UAlberta-EcoCar/Sally-Electrical-Design/README.md

View this project on [CADLAB.io](https://cadlab.io/project/29553). 

# EcoCar Sally Prototype
***This is the official repository for the 2024-2025 EcoCar prototype, Sally***

Much of the systems of this vehicle will build on the innovations implemented in Lucy. Utilizing CANbus, we can easily add more modules to our overall system. We will also be employing power distribution networks alongside CANbus as to create a more intensively modular system.
