UAlberta-EcoCar/Sally-Electrical-Design/Hardware/Rev1/defogger_and_wiper.kicad_pcb

## KiCad design Hardware/Rev1/defogger_and_wiper.kicad_pcb (2026-05-02)

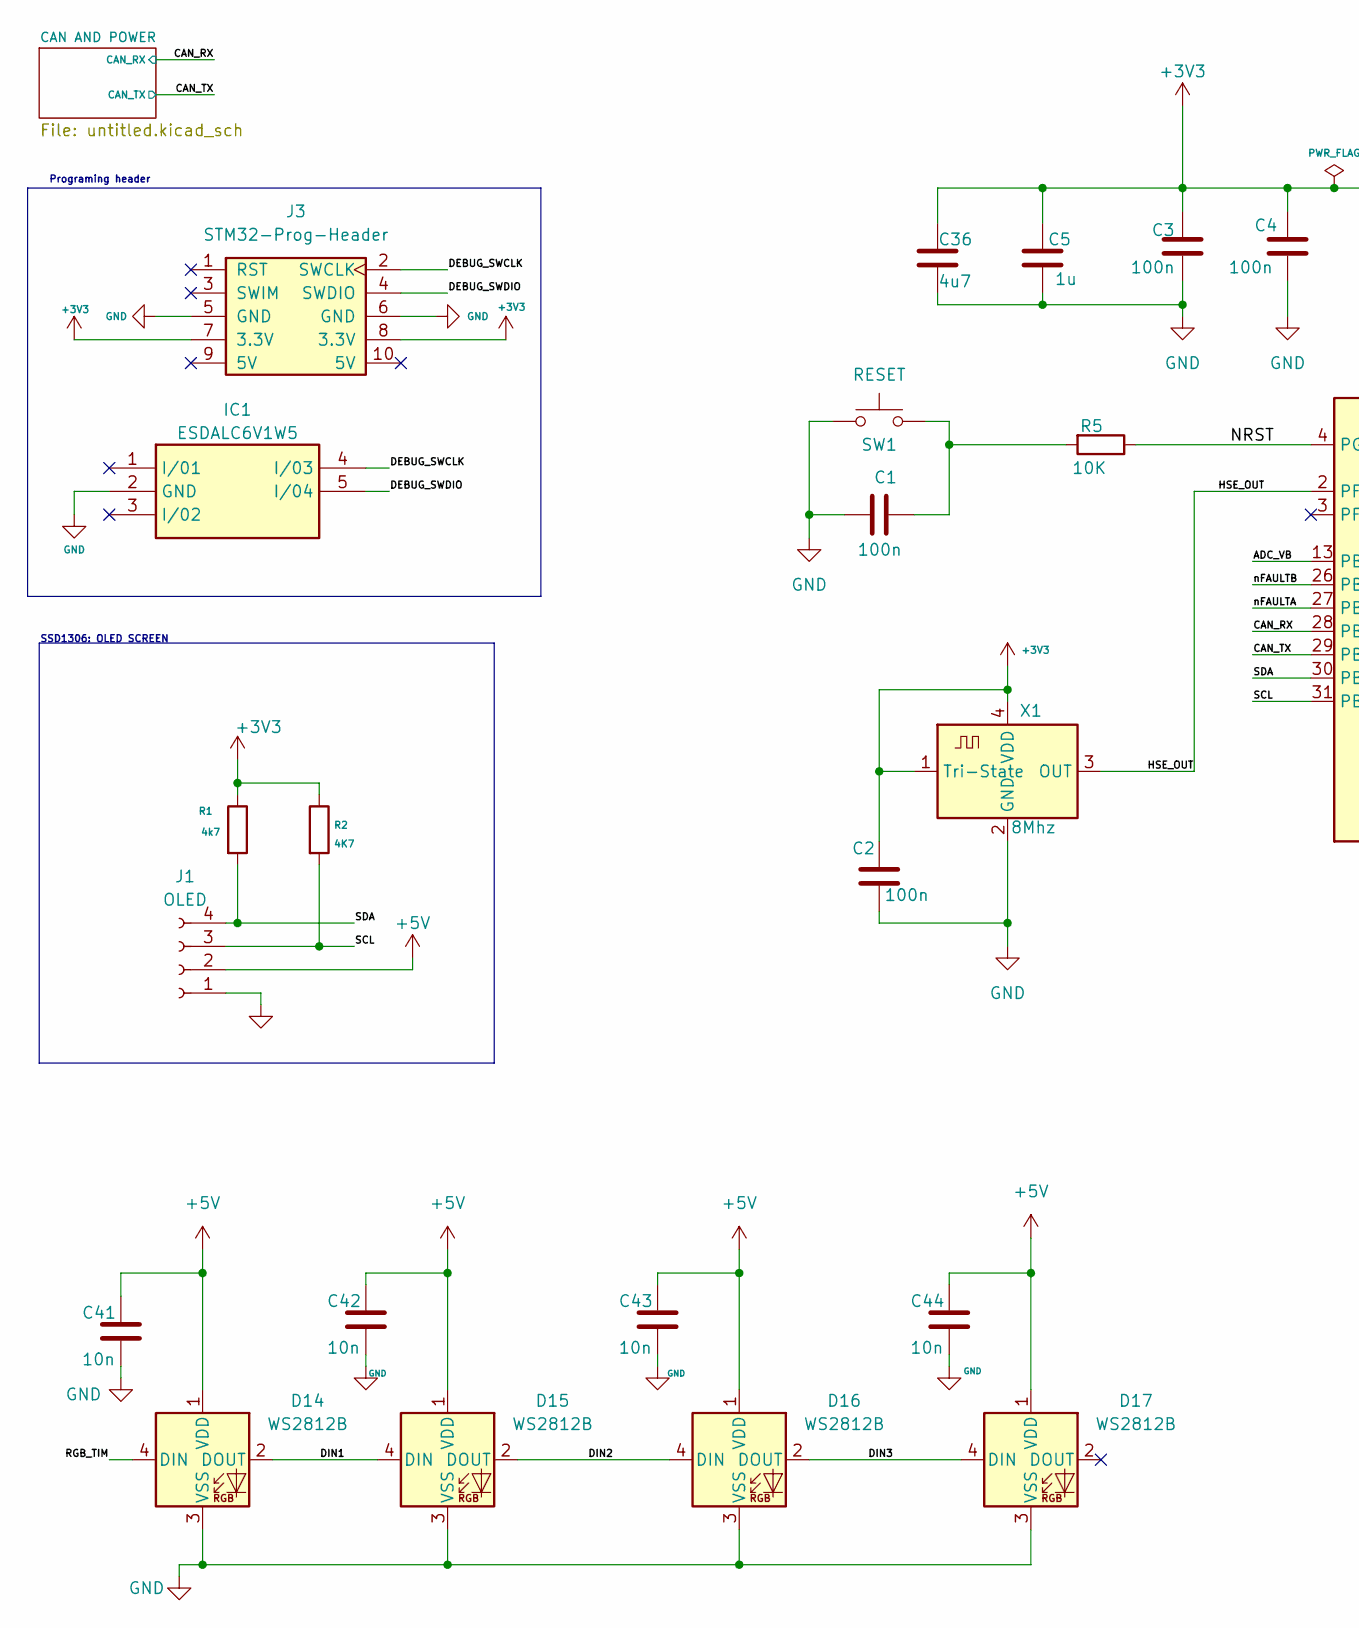
[picture p1: schematic defogger_and_wiper.kicad_sch, Windsheild defogger and wiper, part in row 1, column 1]

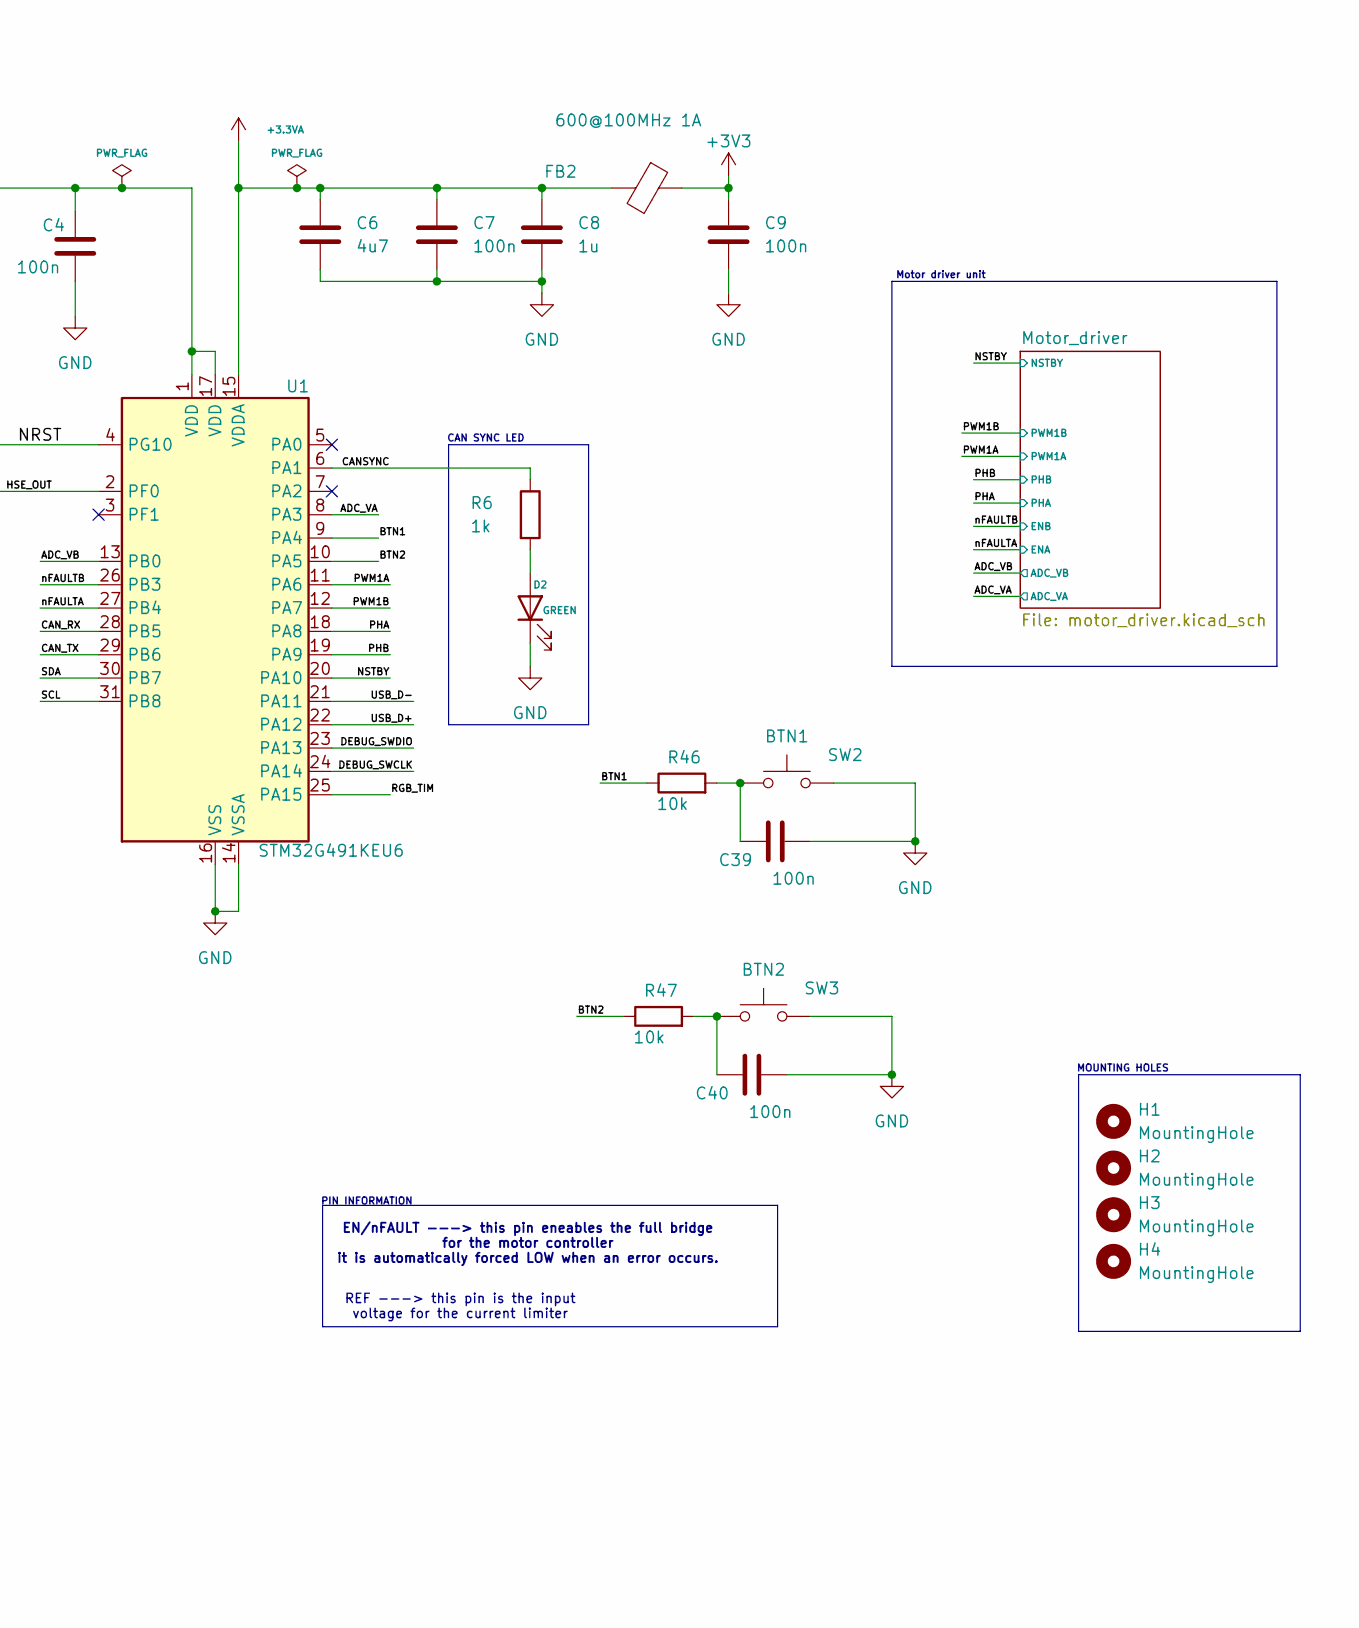
[picture p2: schematic defogger_and_wiper.kicad_sch, Windsheild defogger and wiper, part in row 1, column 2]

Parts:
C1: 100n; C_0603_1608Metric; JLCPCB Part#(Optional) C1525
C2, C3, C4, C39, C40: 100n; C_0603_1608Metric
C5, C8: 1u; C_0603_1608Metric; JLCPCB Part#(Optional) C28323
C6, C36: 4u7; C_0603_1608Metric; JLCPCB Part#(Optional) C96446
C7: 100n; C_0603_1608Metric; JLCPCB Part#(Optional) C96446
C9: 100n; C_0603_1608Metric; JLCPCB Part#(Optional) C28323
C41, C42, C43, C44: 10n; C_0603_1608Metric; LCSC# C100042
D2: GREEN; LED_0603_1608Metric; LCSC# C19273151
D14, D15, D16, D17: WS2812B; LED_WS2812B_PLCC4_5.0x5.0mm_P3.2mm
FB2: 600@100MHz 1A; L_0603_1608Metric; Digikey # 1934-1474-1-ND
H1, H2, H3, H4: MountingHole; MountingHole_3.5mm
IC1: ESDALC6V1W5; SOT65P210X110-5N; JLCPCB Part#(Optional) C2827626
J1: OLED; Display_128x64_096_I2C
J3: STM32-Prog-Header; IDC-STM32-Prog-Header_2x05_P2.54mm_Vertical
R1: 4k7; R_0603_1608Metric
R2: 4K7; R_0603_1608Metric
R5: 10K; R_0603_1608Metric
R6: 1k; R_0603_1608Metric; LCSC# C21190
R46, R47: 10k; R_0603_1608Metric
SW1: RESET; SW_PUSH_6mm_H5mm
SW2: BTN1; SW_PUSH_6mm_H5mm
SW3: BTN2; SW_PUSH_6mm_H5mm
U1: STM32G491KEU6; QFN-32-1EP_5x5mm_P0.5mm_EP3.45x3.45mm
X1: 8Mhz; Crystal_SMD_3225-4Pin_3.2x2.5mm

Connections:
+3.3VA: C6.1, C7.1, C8.1, FB2.2, U1.15 (VDDA)
+3V3: C2.1, C3.1, C4.1, C5.1, C9.1, C36.1, FB2.1, J3.7 (3.3V), J3.8 (3.3V), R1.1, R2.1, U1.1 (VDD), U1.17 (VDD), X1.1 (Tri-State), X1.4 (VDD); also elsewhere on the board
+5V: C41.1, C42.1, C43.1, C44.1, D14.1 (VDD), D15.1 (VDD), D16.1 (VDD), D17.1 (VDD), J1.2; also elsewhere on the board
/ADC_VA: U1.8 (PA3); also elsewhere on the board
/ADC_VB: U1.13 (PB0); also elsewhere on the board
/BTN1: R46.1, U1.9 (PA4)
/BTN2: R47.1, U1.10 (PA5)
/CANSYNC: R6.1, U1.6 (PA1)
/CAN_RX: U1.28 (PB5); also elsewhere on the board
/CAN_TX: U1.29 (PB6); also elsewhere on the board
/DEBUG_SWCLK: IC1.4 (I/03), J3.2 (SWCLK), U1.24 (PA14)
/DEBUG_SWDIO: IC1.5 (I/04), J3.4 (SWDIO), U1.23 (PA13)
/DIN1: D14.2 (DOUT), D15.4 (DIN)
/DIN2: D15.2 (DOUT), D16.4 (DIN)
/DIN3: D16.2 (DOUT), D17.4 (DIN)
/HSE_OUT: U1.2 (PF0), X1.3 (OUT)
/NRST: R5.1, U1.4 (PG10)
/NSTBY: U1.20 (PA10); also elsewhere on the board
/PHA: U1.18 (PA8); also elsewhere on the board
/PHB: U1.19 (PA9); also elsewhere on the board
/PWM1A: U1.11 (PA6); also elsewhere on the board
/PWM1B: U1.12 (PA7); also elsewhere on the board
/RGB_TIM: D14.4 (DIN), U1.25 (PA15)
/SCL: J1.3, R2.2, U1.31 (PB8)
/SDA: J1.4, R1.2, U1.30 (PB7)
/USB_D+: U1.22 (PA12)
/USB_D-: U1.21 (PA11)
/nFAULTA: U1.27 (PB4); also elsewhere on the board
/nFAULTB: U1.26 (PB3); also elsewhere on the board
GND: C1.1, C2.2, C3.2, C4.2, C5.2, C6.2, C7.2, C8.2, C9.2, C36.2, C39.2, C40.2, C41.2, C42.2, C43.2, C44.2, D2.1 (K), D14.3 (VSS), D15.3 (VSS), D16.3 (VSS), D17.3 (VSS), IC1.2 (GND), J1.1, J3.5 (GND), J3.6 (GND), SW1.1, SW2.2, SW3.2, U1.14 (VSSA), U1.16 (VSS), U1.32 (VSS), U1.33 (VSS), X1.2 (GND); also elsewhere on the board
unnamed: C1.2, R5.2, SW1.2
unnamed: C39.1, R46.2, SW2.1
unnamed: C40.1, R47.2, SW3.1
unnamed: D2.2 (A), R6.2

Notes on the sheet:
PIN INFORMATION
EN/nFAULT ---> this pin eneables the full bridge for the motor controller it is automatically forced LOW when an error occurs.
Programing header
SSD1306: OLED SCREEN
CAN SYNC LED
Motor driver unit
MOUNTING HOLES
REF ---> this pin is the input voltage for the current limiter

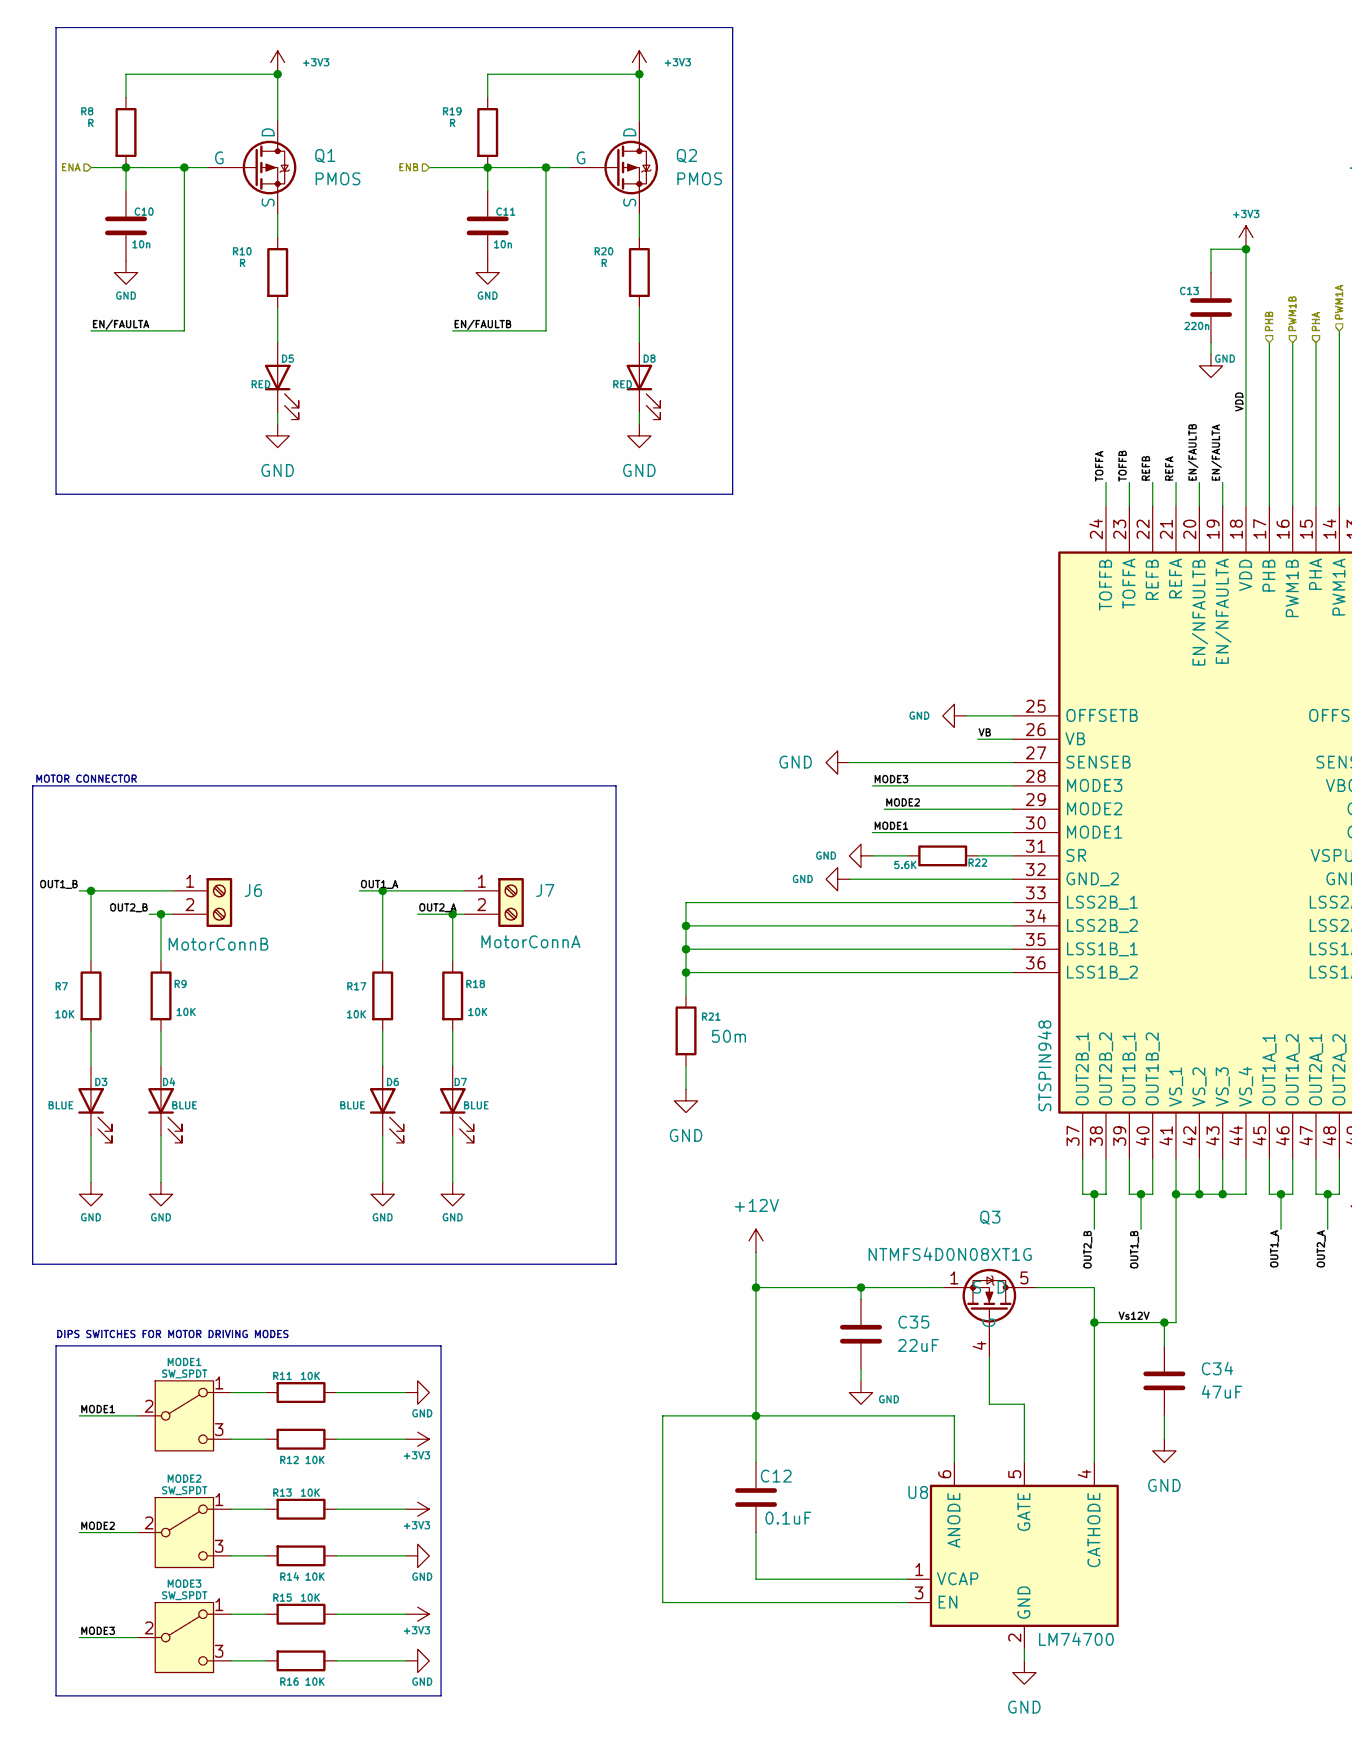
[picture p3: schematic motor_driver.kicad_sch, Motor Driver, part in row 1, column 1]

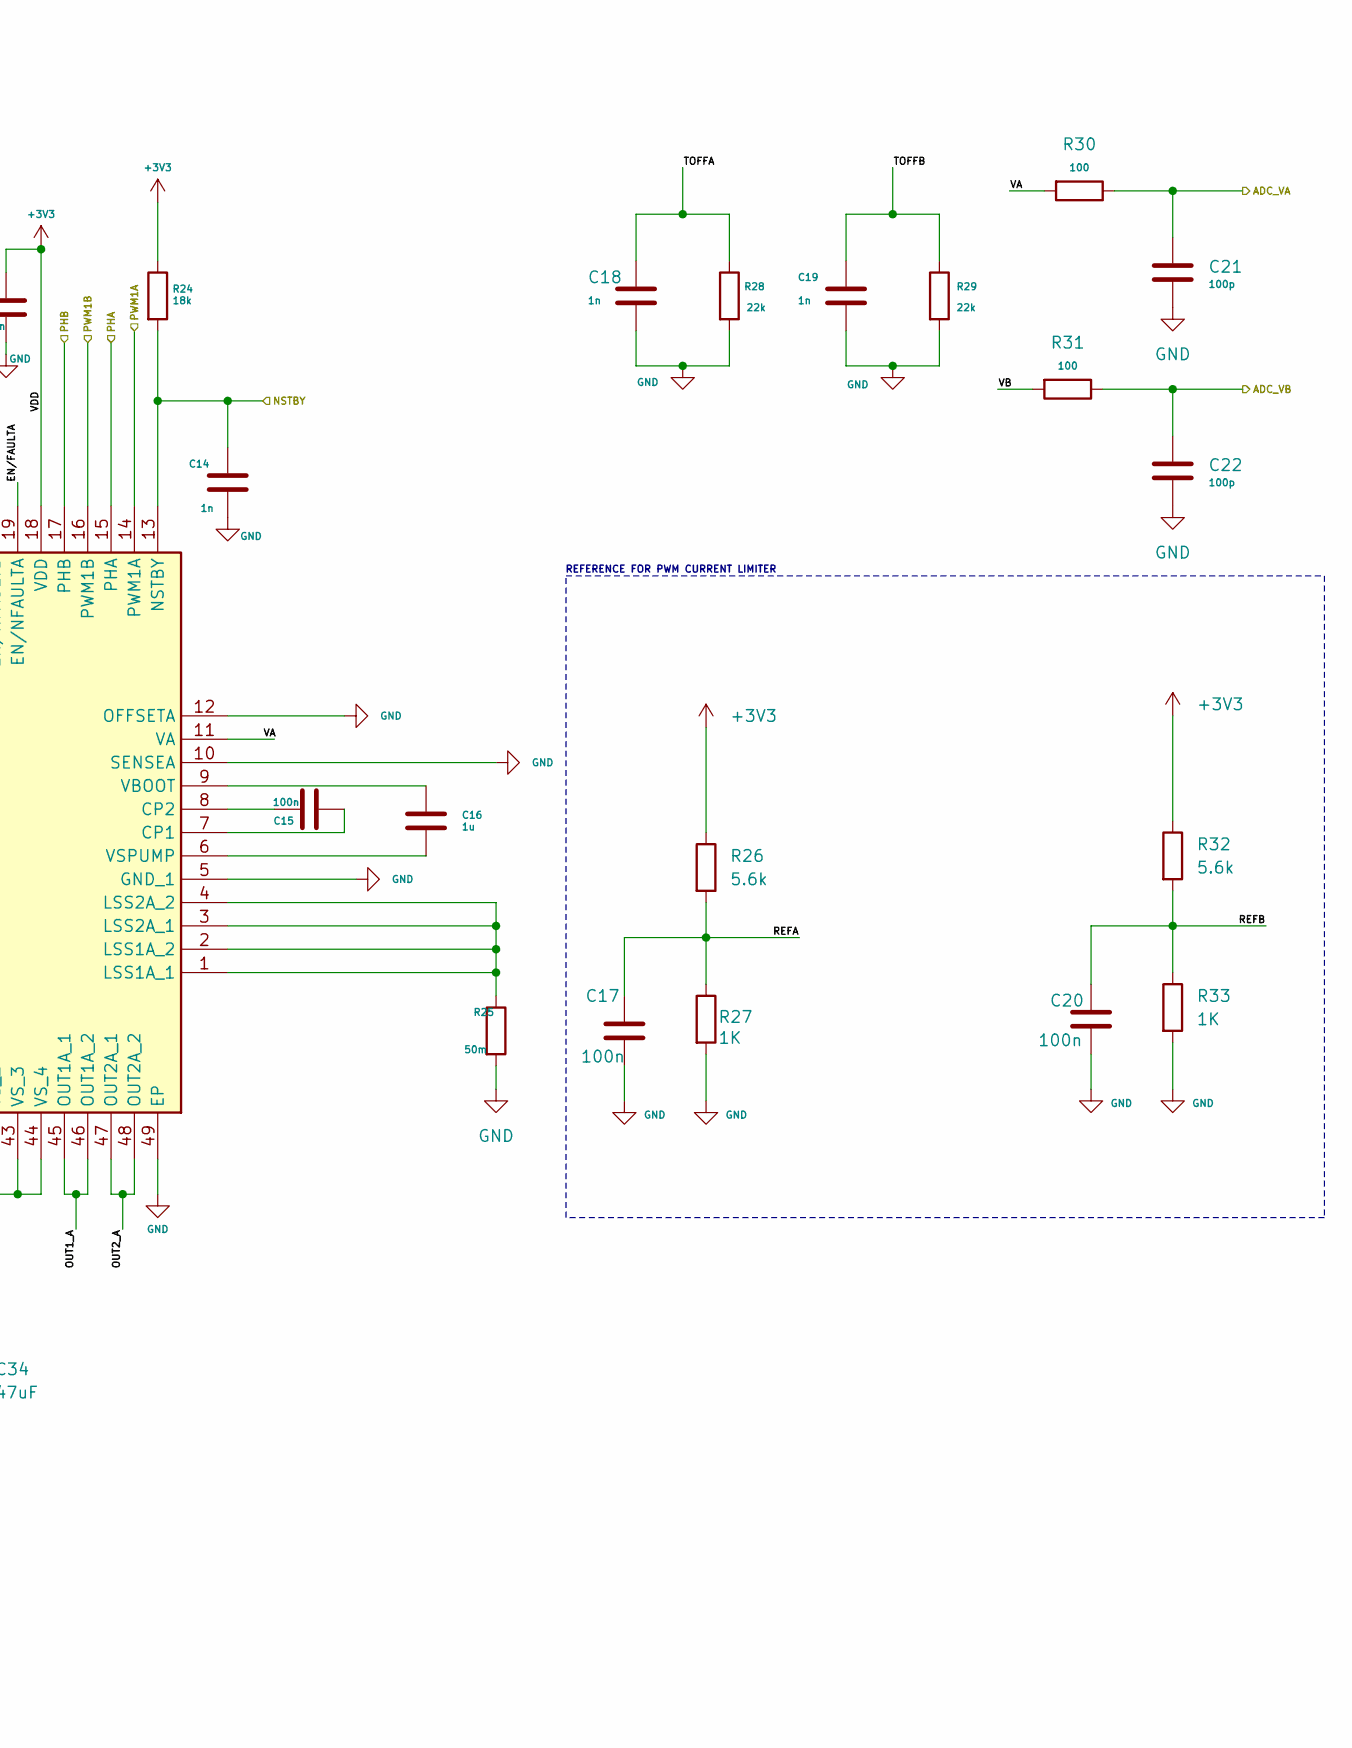
[picture p4: schematic motor_driver.kicad_sch, Motor Driver, part in row 1, column 2]

Parts:
C10, C11: 10n; C_0603_1608Metric; LCSC# C100042
C12: 0.1uF; C_0603_1608Metric
C13: 220n; C_0603_1608Metric
C14, C18, C19: 1n; C_0603_1608Metric
C15, C17, C20: 100n; C_0603_1608Metric
C16: 1u; C_0603_1608Metric
C21, C22: 100p; C_0603_1608Metric
C34: 47uF; C_0603_1608Metric
C35: 22uF; C_0603_1608Metric
D3, D4, D6, D7: BLUE; LED_0603_1608Metric; LCSC# C19171394
D5, D8: RED; LED_0603_1608Metric; LCSC# C19171390
IC2: STSPIN948; QFN50P700X700X105-49N-D; Manufacturer_Part_Number STSPIN948; Mouser Part Number 511-STSPIN948
J6: MotorConnB; TerminalBlock_Phoenix_MKDS-1,5-2-5.08_1x02_P5.08mm_Horizont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
J7: MotorConnA; TerminalBlock_Phoenix_MKDS-1,5-2-5.08_1x02_P5.08mm_Horizont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
MODE1, MODE2, MODE3: SW_SPDT; SW_SPDT_PCM12
Q1, Q2: PMOS; SOT-23_TO-236_318-AT_OSI
Q3: NTMFS4D0N08XT1G; PowerMosDFNHybrid
R7, R9, R11, R12, R13, R14, R15, R16, R17, R18: 10K; R_0603_1608Metric
R8, R10, R19, R20: R; R_0603_1608Metric
R21: 50m; R_1812_4532Metric
R22: 5.6K; R_0603_1608Metric
R24: 18k; R_0603_1608Metric
R25: 50m; R_0603_1608Metric
R26, R32: 5.6k; R_0603_1608Metric
R27, R33: 1K; R_0603_1608Metric
R28, R29: 22k; R_0603_1608Metric
R30, R31: 100; R_0603_1608Metric
U8: LM74700; SOT-23-6

Connections:
+3V3: C13.1, IC2.18 (VDD), Q1.1 (D), Q2.1 (D), R8.1, R12.1, R13.1, R15.1, R19.1, R24.1, R26.1, R32.1; also elsewhere on the board
+12V: C12.1, C35.1, Q3.1 (S), Q3.2 (S), Q3.3 (S), U8.3 (EN), U8.6 (ANODE); also elsewhere on the board
/ADC_VA: C21.1, R30.1; also elsewhere on the board
/ADC_VB: C22.1, R31.1; also elsewhere on the board
/Motor_driver/MODE1: IC2.30 (MODE1), MODE1.2 (B)
/Motor_driver/MODE2: IC2.29 (MODE2), MODE2.2 (B)
/Motor_driver/MODE3: IC2.28 (MODE3), MODE3.2 (B)
/Motor_driver/OUT1_A: IC2.45 (OUT1A_1), IC2.46 (OUT1A_2), J7.1, R17.1
/Motor_driver/OUT1_B: IC2.39 (OUT1B_1), IC2.40 (OUT1B_2), J6.1, R7.1
/Motor_driver/OUT2_A: IC2.47 (OUT2A_1), IC2.48 (OUT2A_2), J7.2, R18.1
/Motor_driver/OUT2_B: IC2.37 (OUT2B_1), IC2.38 (OUT2B_2), J6.2, R9.1
/Motor_driver/REFA: C17.1, IC2.21 (REFA), R26.2, R27.1
/Motor_driver/REFB: C20.1, IC2.22 (REFB), R32.2, R33.1
/Motor_driver/TOFFA: C18.2, IC2.24 (TOFFB), R28.1
/Motor_driver/TOFFB: C19.2, IC2.23 (TOFFA), R29.1
/Motor_driver/VA: IC2.11 (VA), R30.2
/Motor_driver/VB: IC2.26 (VB), R31.2
/Motor_driver/Vs12V: C34.1, IC2.41 (VS_1), IC2.42 (VS_2), IC2.43 (VS_3), IC2.44 (VS_4), Q3.5 (D), U8.4 (CATHODE)
/NSTBY: C14.1, IC2.13 (NSTBY), R24.2; also elsewhere on the board
/PHA: IC2.15 (PHA); also elsewhere on the board
/PHB: IC2.17 (PHB); also elsewhere on the board
/PWM1A: IC2.14 (PWM1A); also elsewhere on the board
/PWM1B: IC2.16 (PWM1B); also elsewhere on the board
/nFAULTA: C10.1, IC2.19 (EN/NFAULTA), Q1.2 (G), R8.2; also elsewhere on the board
/nFAULTB: C11.1, IC2.20 (EN/NFAULTB), Q2.2 (G), R19.2; also elsewhere on the board
GND: C10.2, C11.2, C13.2, C14.2, C17.2, C18.1, C19.1, C20.2, C21.2, C22.2, C34.2, C35.2, D3.1 (K), D4.1 (K), D5.1 (K), D6.1 (K), D7.1 (K), D8.1 (K), IC2.5 (GND_1), IC2.10 (SENSEA), IC2.12 (OFFSETA), IC2.25 (OFFSETB), IC2.27 (SENSEB), IC2.32 (GND_2), IC2.49 (EP), R11.1, R14.1, R16.1, R21.2, R22.1, R25.2, R27.2, R28.2, R29.2, R33.2, U8.2 (GND); also elsewhere on the board
unnamed: D3.2 (A), R7.2
unnamed: D4.2 (A), R9.2
unnamed: D5.2 (A), R10.2
unnamed: D6.2 (A), R17.2
unnamed: D7.2 (A), R18.2
unnamed: D8.2 (A), R20.2
unnamed: C15.1, IC2.7 (CP1)
unnamed: C15.2, IC2.8 (CP2)
unnamed: IC2.1 (LSS1A_1), IC2.2 (LSS1A_2), IC2.3 (LSS2A_1), IC2.4 (LSS2A_2), R25.1
unnamed: IC2.33 (LSS2B_1), IC2.34 (LSS2B_2), IC2.35 (LSS1B_1), IC2.36 (LSS1B_2), R21.1
unnamed: IC2.31 (SR), R22.2
unnamed: C16.1, IC2.9 (VBOOT)
unnamed: C16.2, IC2.6 (VSPUMP)
unnamed: MODE1.1 (A), R11.2
unnamed: MODE1.3 (C), R12.2
unnamed: MODE2.1 (A), R13.2
unnamed: MODE2.3 (C), R14.2
unnamed: MODE3.1 (A), R15.2
unnamed: MODE3.3 (C), R16.2
unnamed: Q1.3 (S), R10.1
unnamed: Q2.3 (S), R20.1
unnamed: Q3.4 (G), U8.5 (GATE)
unnamed: C12.2, U8.1 (VCAP)

Notes on the sheet:
MOTOR CONNECTOR
DIPS SWITCHES FOR MOTOR DRIVING MODES
REFERENCE FOR PWM CURRENT LIMITER

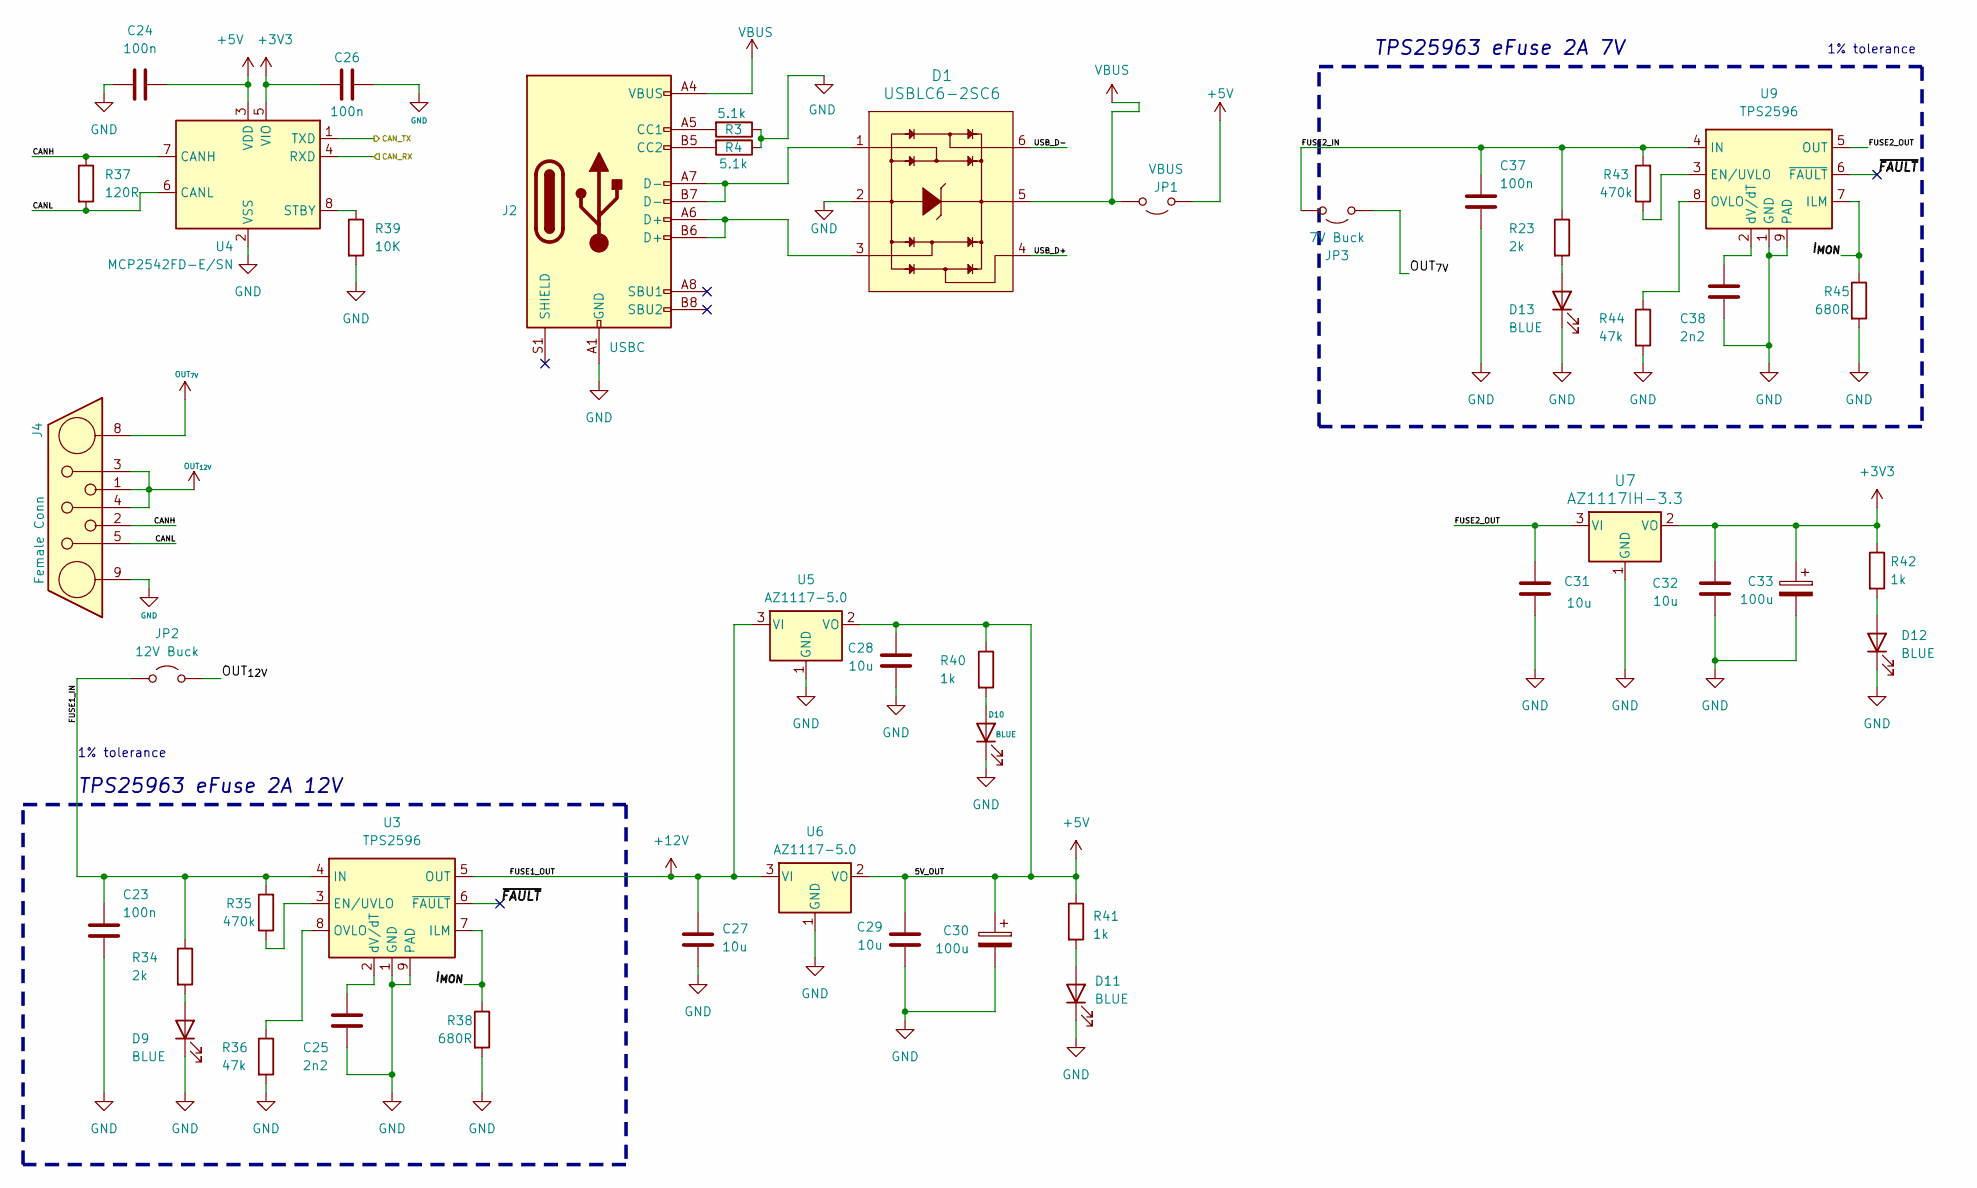
[picture p5: schematic untitled.kicad_sch]

Parts:
C23, C37: 100n; C_0603_1608Metric; JLCPCB Part#(Optional) C28233
C24, C26: 100n; C_0603_1608Metric; JLCPCB Part#(Optional) C1525
C25, C38: 2n2; C_0603_1608Metric; JLCPCB Part#(Optional) C1531
C27, C28, C29, C31, C32: 10u; C_0805_2012Metric; LCSC# C15850
C30, C33: 100u; CP_Elec_6.3x9.9; LCSC# C72478
D1: USBLC6-2SC6; TSOT-23-6; Digikey # 497-5235-1-ND
D9, D10, D11, D12, D13: BLUE; LED_0603_1608Metric; LCSC# C19171394
J2: USBC; USB_C_Receptacle_GCT_USB4105-xx-A_16P_TopMnt_Horizontal
J4: Female Conn; DB7W2-Female
JP1: VBUS; J_0603_Triangular
JP2: 12V Buck; J_0603_Triangular
JP3: 7V Buck; J_0603_Triangular
R3, R4: 5.1k; R_0603_1608Metric; JLCPCB Part#(Optional) C17557
R23, R34: 2k; R_0603_1608Metric; JLCPCB Part#(Optional) C17604
R35, R43: 470k; R_0603_1608Metric; JLCPCB Part#(optional) C17709
R36, R44: 47k; R_0603_1608Metric; JLCPCB Part#(optional) C17713
R37: 120R; R_0603_1608Metric
R38, R45: 680R; R_0603_1608Metric; JLCPCB Part#(Optional) C23220
R39: 10K; R_0603_1608Metric
R40, R41, R42: 1k; R_0603_1608Metric; LCSC# C21190
U3, U9: TPS2596; TI_SO-PowerPAD-8
U4: MCP2542FD-E/SN; SOIC-8_3.9x4.9mm_P1.27mm; Digikey # MCP2542FD-E/SN-ND
U5, U6: AZ1117-5.0; SOT-223-3_TabPin2
U7: AZ1117IH-3.3; SOT-223-3_TabPin2

Connections:
+3V3: C26.2, C32.1, C33.1, R42.1, U4.5 (VIO), U7.2 (VO); also elsewhere on the board
+5V: C24.2, C28.1, C29.1, C30.1, JP1.1 (A), R40.1, R41.1, U4.3 (VDD), U5.2 (VO), U6.2 (VO); also elsewhere on the board
+12V: C27.1, U3.5 (OUT), U5.3 (VI), U6.3 (VI); also elsewhere on the board
/CAN AND POWER/CANH: J4.2, R37.1, U4.7 (CANH)
/CAN AND POWER/CANL: J4.5, R37.2, U4.6 (CANL)
/CAN AND POWER/FUSE1_IN: C23.1, JP2.1 (A), R34.1, R35.2, U3.4 (IN)
/CAN AND POWER/FUSE2_IN: C37.1, JP3.1 (A), R23.1, R43.2, U9.4 (IN)
/CAN AND POWER/FUSE2_OUT: C31.1, U7.3 (VI), U9.5 (OUT)
/CAN AND POWER/I_{MON}: R38.1, R45.1, U3.7 (ILM), U9.7 (ILM)
/CAN AND POWER/USB_D+: D1.4
/CAN AND POWER/USB_D-: D1.6
/CAN AND POWER/~FAULT: U3.6 (~FAULT), U9.6 (~FAULT)
/CAN_RX: U4.4 (RXD); also elsewhere on the board
/CAN_TX: U4.1 (TXD); also elsewhere on the board
GND: C23.2, C24.1, C25.2, C26.1, C27.2, C28.2, C29.2, C30.2, C31.2, C32.2, C33.2, C37.2, C38.2, D1.2, D9.1 (K), D10.1 (K), D11.1 (K), D12.1 (K), D13.1 (K), J2.A1 (GND), J2.A12 (GND), J2.B1 (GND), J2.B12 (GND), J4.9, R3.1, R4.1, R36.2, R38.2, R39.2, R44.2, R45.2, U3.1 (GND), U3.9 (PAD), U4.2 (VSS), U4.9 (VSS), U5.1 (GND), U6.1 (GND), U7.1 (GND), U9.1 (GND), U9.9 (PAD); also elsewhere on the board
unnamed: D1.1, J2.A7 (D-), J2.B7 (D-)
unnamed: D1.3, J2.A6 (D+), J2.B6 (D+)
unnamed: D9.2 (A), R34.2
unnamed: D10.2 (A), R40.2
unnamed: D11.2 (A), R41.2
unnamed: D12.2 (A), R42.2
unnamed: D13.2 (A), R23.2
unnamed: J2.A5 (CC1), R3.2
unnamed: J2.B5 (CC2), R4.2
unnamed: R35.1, U3.3 (EN/UVLO)
unnamed: R36.1, U3.8 (OVLO)
unnamed: C25.1, U3.2 (dV/dT)
unnamed: R39.1, U4.8 (STBY)
unnamed: R43.1, U9.3 (EN/UVLO)
unnamed: R44.1, U9.8 (OVLO)
unnamed: C38.1, U9.2 (dV/dT)
OUT_{7V}: J4.8, JP3.2 (B)
OUT_{12V}: J4.1, J4.3, J4.4, JP2.2 (B)
VBUS: D1.5, J2.A4 (VBUS), J2.A9 (VBUS), J2.B4 (VBUS), J2.B9 (VBUS), JP1.2 (B)

Notes on the sheet:
TPS25963 eFuse 2A 12V
1% tolerance
TPS25963 eFuse 2A 7V

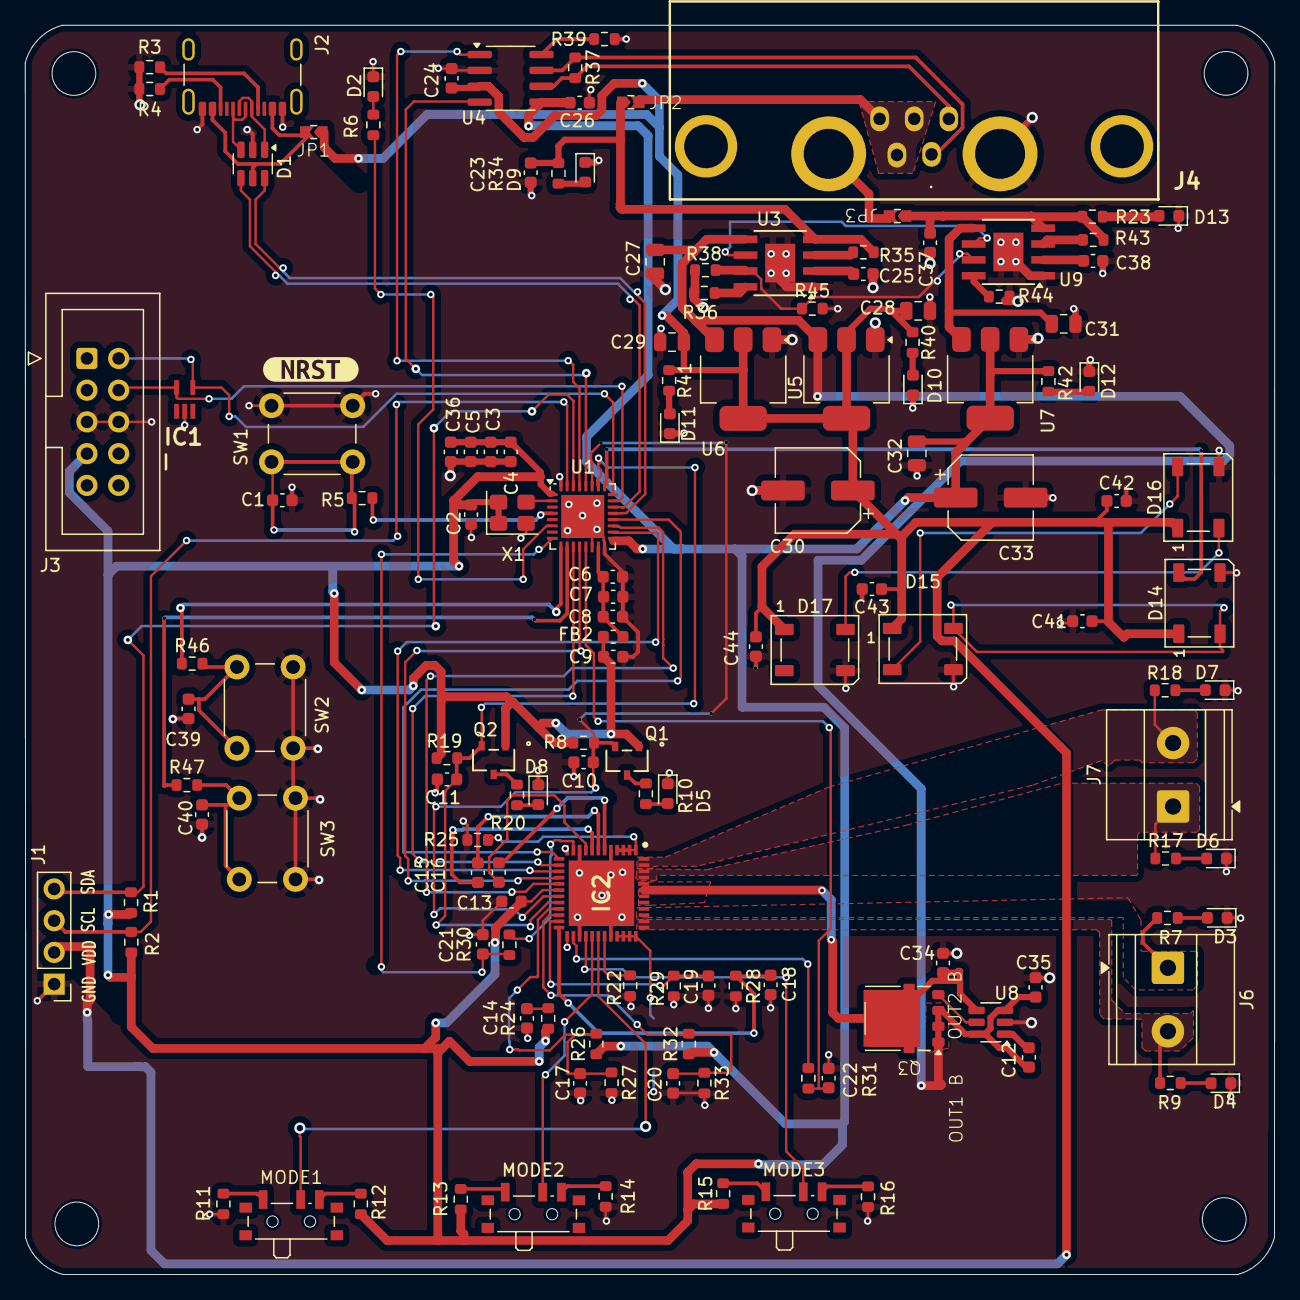
[picture p6: board defogger_and_wiper.kicad_pcb from above]

Board: 4 copper layers, 100.0 x 100.0 mm, 143 parts (1 on the bottom side), 96 nets.

Other parts of the board:
kibuzzard-696D2580: G***; kibuzzard-696D2580
