UAlberta-EcoCar/Sally-Electrical-Design/(threads)

Thread 1 (2025-07-03):

Brake and Headlight Boards

abinash18, 2025-07-03:

abinash18, 2025-07-13:
Will be using ws2182B leds from lcsc because they are dirt cheap and digikey is too expensive. also will ask jacob for a beter oven for them

Also talked with adrian and ekjot ab the boards; The lights will be on daughter boards. Each will be connected with a 6pin molex micro fit, 4 pins 5v and GND and 2 pins temp sense and DIN.

4 bucks will be on the man controller board which will power

ecss18, 2025-09-20:
To do:
- [ ] Add outputs on a different sheet
- [ ] Protection circuit(s) (e-fuses right after inputs)
- [ ] Add USB-C receptor with ESD protection
- [ ] Add a D-sub connector for inputs (CAN and input voltages 7 & 12V)
- [ ] Add CAN transceiver circuit (with ESD protection) and blinking LED (specify on silk screen)
- [ ] Add current sensing (including an isolation circuit for that so it's not directly connected to the MCU)
Note: the current sensor will send a voltage to MCU which can be programmed to calculate the current and display it using an OLED or save the data in the MCU and send it to the RF module via CAN)
- [ ] Add an OLED and its pin connections, and program it using STM and ecocar library

Thread 2 (2025-07-03):

Brake Temperature and suspension height measurement Sensors

abinash18, 2025-07-03:
Brake temperature sensor board with suspension height measurement interface. IR Temperature measurement.

- Patricia

owang-587, 2025-07-05:
started flow chart

owang-587, 2025-07-06:
found the two candidates for IR temp sensors:
DTPA-UART-1616S
D6T-44L-06H

abinash18, 2025-07-24:
Road wettness with reflectivity sensor of somekind

Thread 3 (2025-07-03):

Windsheild wiper and defogger board

abinash18, 2025-07-03:
Windshield motor driver and defogger with a light sensor that automatically activates the de fogging.

Efraimxyz, 2025-07-05:
low-cost proximity sensor for fog detection study:
https://aaqr.org/articles/aaqr-19-11-oa-0612

abinash18, 2025-07-17:
https://www.digikey.ca/en/products/detail/stmicroelectronics/VL53L3CXV0DH-1/11658314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

abinash18, 2025-07-17:
Have manual control over both

Thread 4 (2025-07-03):

Relay Board redo with solid state mosfets or relays,

abinash18, 2025-07-03:

zhaque3, 2025-07-13:
Use solid state relays instead of mosefets used on FET-Board

AZDC007-1AE-12D possibly?

Isolation not needed

Thread 8 (2025-07-03):

Power Mux controller using ideal diode controllers.

abinash18, 2025-07-03:

abinash18, 2025-07-13:
I asked patricia to help out on this and she is thinking about different ideas on haveing a reliable and robust switch over with a backup failover in case of emergency. I think just having the switch over connected to motor power input (before boost) will be good. So when the car is in run mode the Ideal diode controller for the low poower system is turned on there is latching circuitry powered by the battery that controls when the power to the car should be on from the fuel cell.

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

Thread 13 (2025-07-06):

brake temp sensor

owang-587, 2025-07-06:

owang-587, 2025-07-12:
MLX90641ESF-BCB-000-SP

owang-587, 2025-07-16:
MLX90641ESF-BCA-000-SP

abinash18, 2025-07-16:
https://www.digikey.ca/en/products/detail/omron-electronics-inc-emc-div/D6T-8L-09H/10716557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

This is reasonable aswell although over 40 dollar cap but extreamly enticing
