UAlberta-EcoCar/Sally-Electrical-Design/Hardware/Rev1/firmware/Core/Inc/main.h

#define CAN_SYNC_Pin GPIO_PIN_1
#define CAN_SYNC_GPIO_Port GPIOA
#define ADC_VA_Pin GPIO_PIN_3
#define ADC_VA_GPIO_Port GPIOA
#define PIN1_Pin GPIO_PIN_4
#define PIN1_GPIO_Port GPIOA
#define PIN2_Pin GPIO_PIN_5
#define PIN2_GPIO_Port GPIOA
#define PWM1A_Pin GPIO_PIN_6
#define PWM1A_GPIO_Port GPIOA
#define PWM1B_Pin GPIO_PIN_7
#define PWM1B_GPIO_Port GPIOA
#define ADC_VB_Pin GPIO_PIN_0
#define ADC_VB_GPIO_Port GPIOB
#define PHA_Pin GPIO_PIN_8
#define PHA_GPIO_Port GPIOA
#define PHB_Pin GPIO_PIN_9
#define PHB_GPIO_Port GPIOA
#define NSTBY_Pin GPIO_PIN_10
#define NSTBY_GPIO_Port GPIOA
#define PIN3_Pin GPIO_PIN_15
#define PIN3_GPIO_Port GPIOA
#define ENB_Pin GPIO_PIN_3
#define ENB_GPIO_Port GPIOB
#define ENA_Pin GPIO_PIN_4
#define ENA_GPIO_Port GPIOB
#define OLED_SDA_Pin GPIO_PIN_7
#define OLED_SDA_GPIO_Port GPIOB
#define OLED_SCL_Pin GPIO_PIN_8
#define OLED_SCL_GPIO_Port GPIOB
