UAlberta-EcoCar/Sally-Electrical-Design/(commit log)

2024-05-29 Initializing the Sally Prototype Repository
2024-05-29 Adding ignore file for KiCad temp files
2025-09-14 New dip switches for the driving modes
    [defogger_and_wiper.kicad_sch, motor_driver.kicad_sch]
2025-10-04 updated current limiter design and added pull-ups to OLED screen
    [defogger_and_wiper.kicad_pcb, defogger_and_wiper.kicad_sch, motor_driver.kicad_sch, untitled.kicad_sch]
2025-10-23 Ideal didode controller
    [defogger_and_wiper.kicad_pcb, defogger_and_wiper.kicad_sch, motor_driver.kicad_sch, untitled.kicad_sch]
2025-10-25 component placement
    [defogger_and_wiper.kicad_pcb, defogger_and_wiper.kicad_sch]
2025-11-22 added the voltage rails
    [defogger_and_wiper.kicad_pcb, defogger_and_wiper.kicad_sch]
2025-11-27 finished routing need ERC
    [defogger_and_wiper.kicad_pcb, defogger_and_wiper.kicad_sch, motor_driver.kicad_sch]
2025-11-30 finished layout for review
    [defogger_and_wiper.kicad_pcb, defogger_and_wiper.kicad_sch]
2026-01-03 Changed layout worksesh Jan 3rd 2026
    [defogger_and_wiper.kicad_pcb, defogger_and_wiper.kicad_sch, motor_driver.kicad_sch, untitled.kicad_sch]
2026-01-11 updated the power lines
    [defogger_and_wiper.kicad_pcb, motor_driver.kicad_sch]
2026-01-17 used zones to route power
    [defogger_and_wiper.kicad_pcb, motor_driver.kicad_sch]
2026-01-18 clean up
    [defogger_and_wiper.kicad_pcb, defogger_and_wiper.kicad_sch]
2026-01-19 changed to buses for 3v3 and did DRC
    [defogger_and_wiper.kicad_pcb, motor_driver.kicad_sch]
2026-02-16 connectors changed, routing to do
    [defogger_and_wiper.kicad_pcb, motor_driver.kicad_sch, untitled.kicad_sch]
2026-03-28 updated layout
    [defogger_and_wiper.kicad_pcb, defogger_and_wiper.kicad_sch, motor_driver.kicad_sch, untitled.kicad_sch]
2026-04-04 added RGB Leds
    [defogger_and_wiper.kicad_pcb]
2026-05-02 2026-05-02 changes
    [defogger_and_wiper.kicad_pcb, defogger_and_wiper.kicad_sch]
2026-06-06 Finished all revisions
    [CANandPower.kicad_sch]
