UAlberta-EcoCar/Sally-Electrical-Design/(notices)

Notices in the files:
Hardware/Rev1/firmware/Core/Inc/main.h:
Copyright (c) 2025 STMicroelectronics.
All rights reserved.
This software is licensed under terms that can be found in the LICENSE file
